Lukelectro/PowerNode/HiLink_Ali.jpg

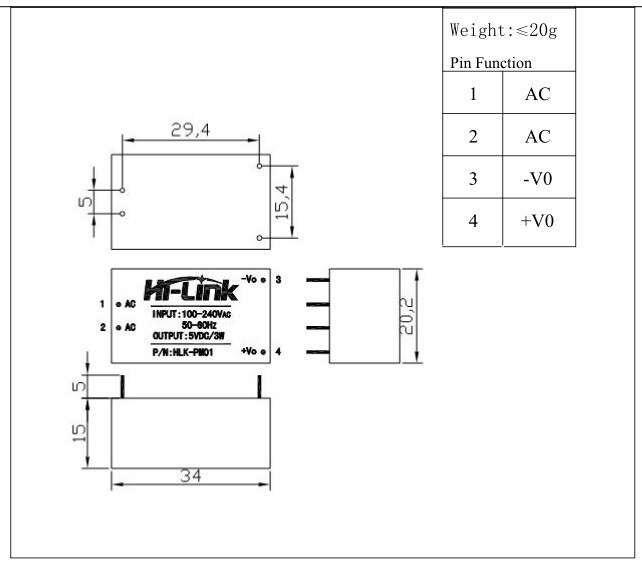
HiLink_Ali.jpg
