Lukelectro/PowerNode/Poesp_1.0.pdf

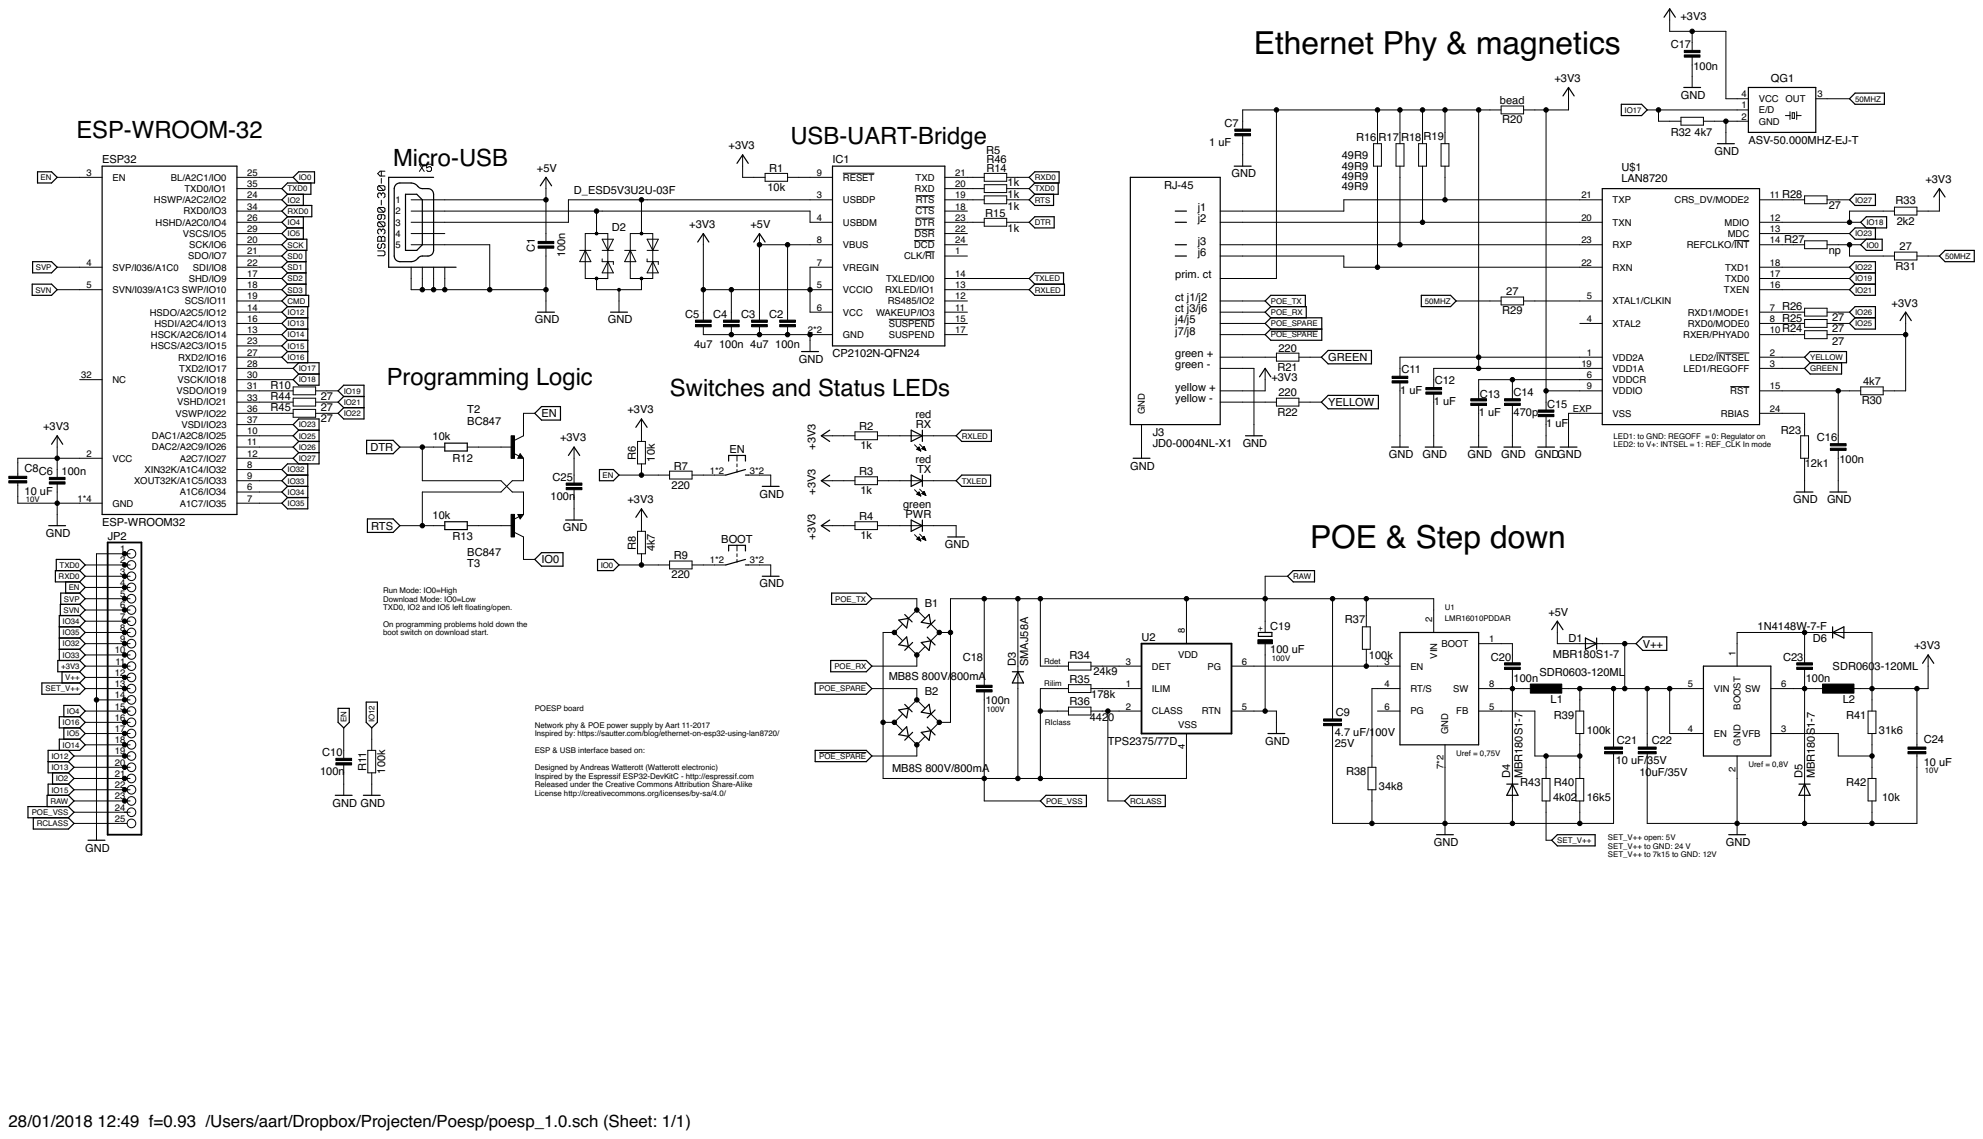
[picture p2: page 1]

Switches and Status LEDs Programming Logic

LED1: to GND: REGOFF = 0: Regulator on
LED2: to V+: INTSEL = 1: REF_CLK In mode

Run Mode: IO0=High Download Mode: IO0=Low

TXD0, IO2 and IO5 left floating/open. On programming problems hold down the

boot switch on download start.

POESP board Network phy & POE power supply by Aart 11-2017

Inspired by: https://sautter.com/blog/ethernet-on-esp32-using-lan8720/ ESP & USB interface based on: Designed by Andreas Watterott (Watterott electronic)

Inspired by the Espressif ESP32-DevKitC - http://espressif.com
Released under the Creative Commons Attribution Share-Alike
License http://creativecommons.org/licenses/by-sa/4.0/

28/01/2018 12:49 f=0.93 /Users/aart/Dropbox/Projecten/Poesp/poesp_1.0.sch (Sheet: 1/1)
