Lukelectro/PowerNode/PoESP_Powernode_v1p1_zoals_board_gemaakt_is.pdf

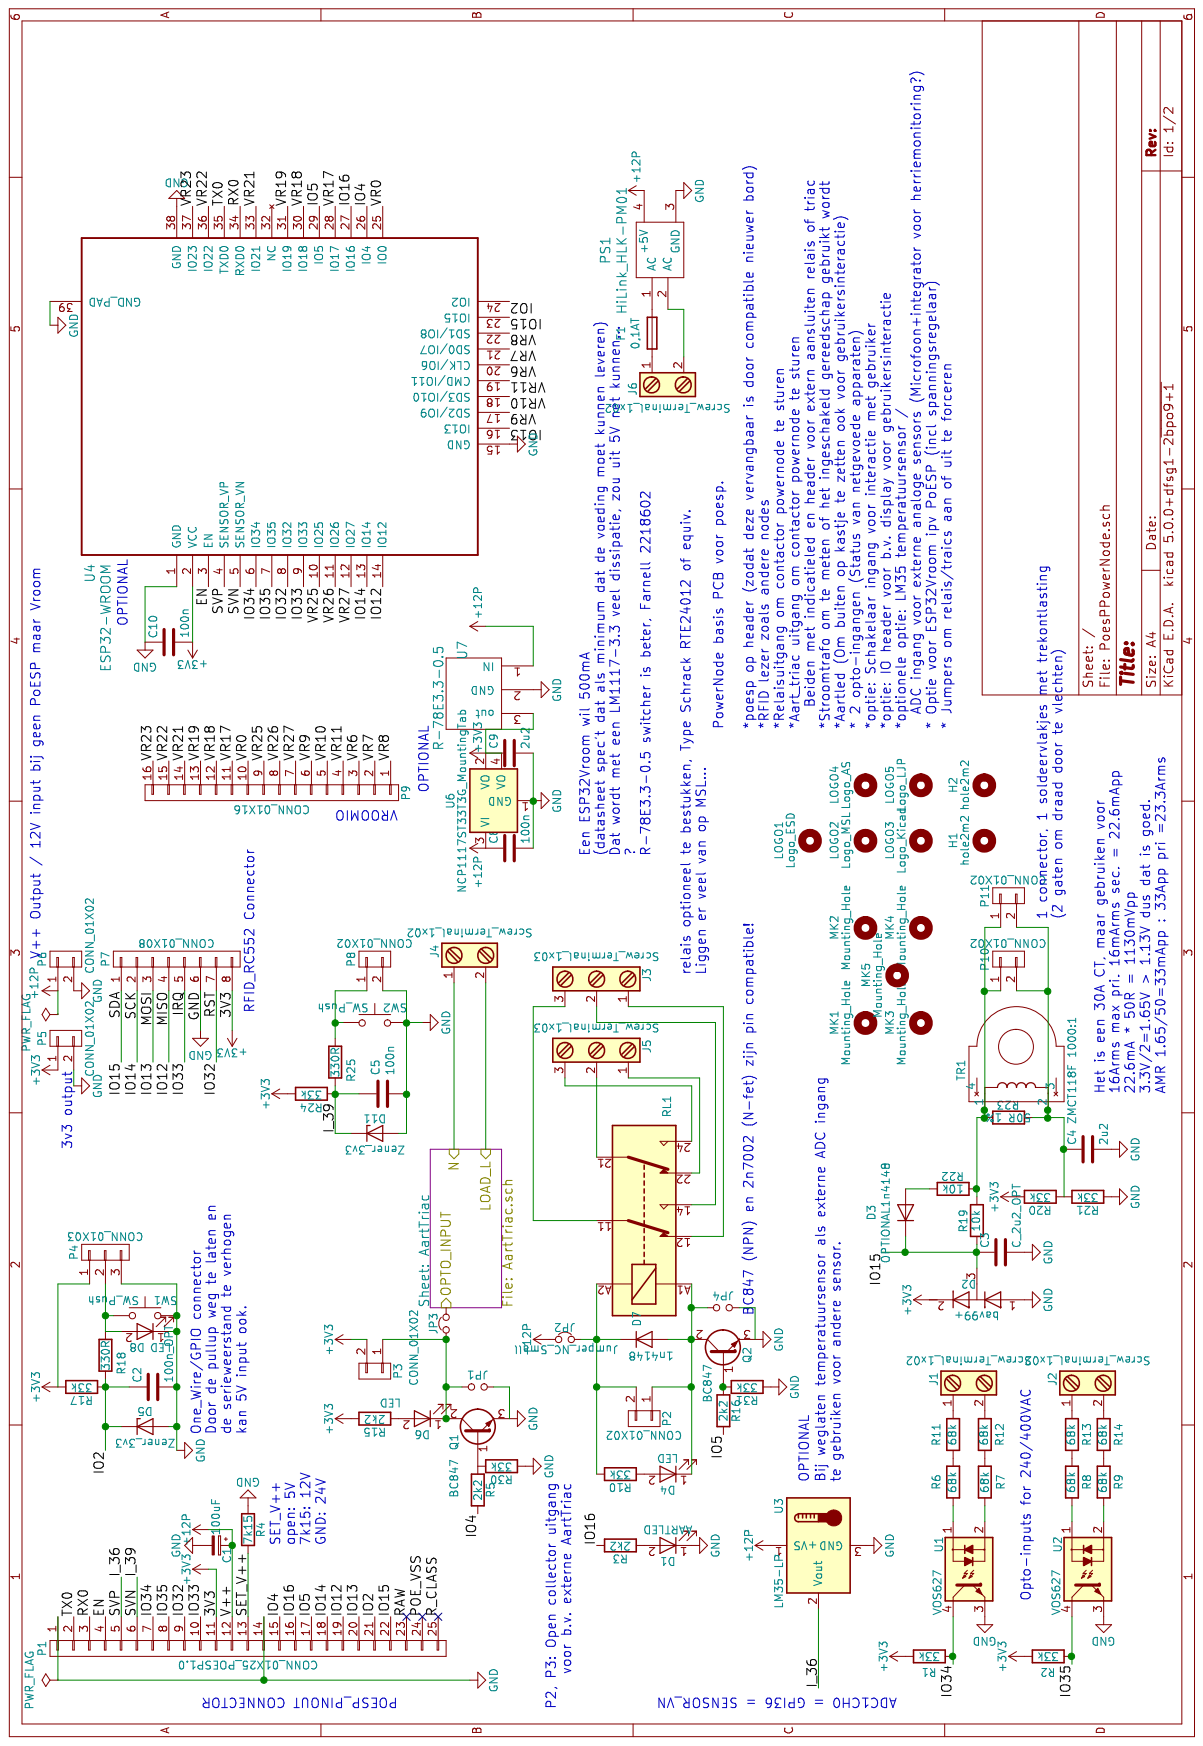
[picture p3: page 1]

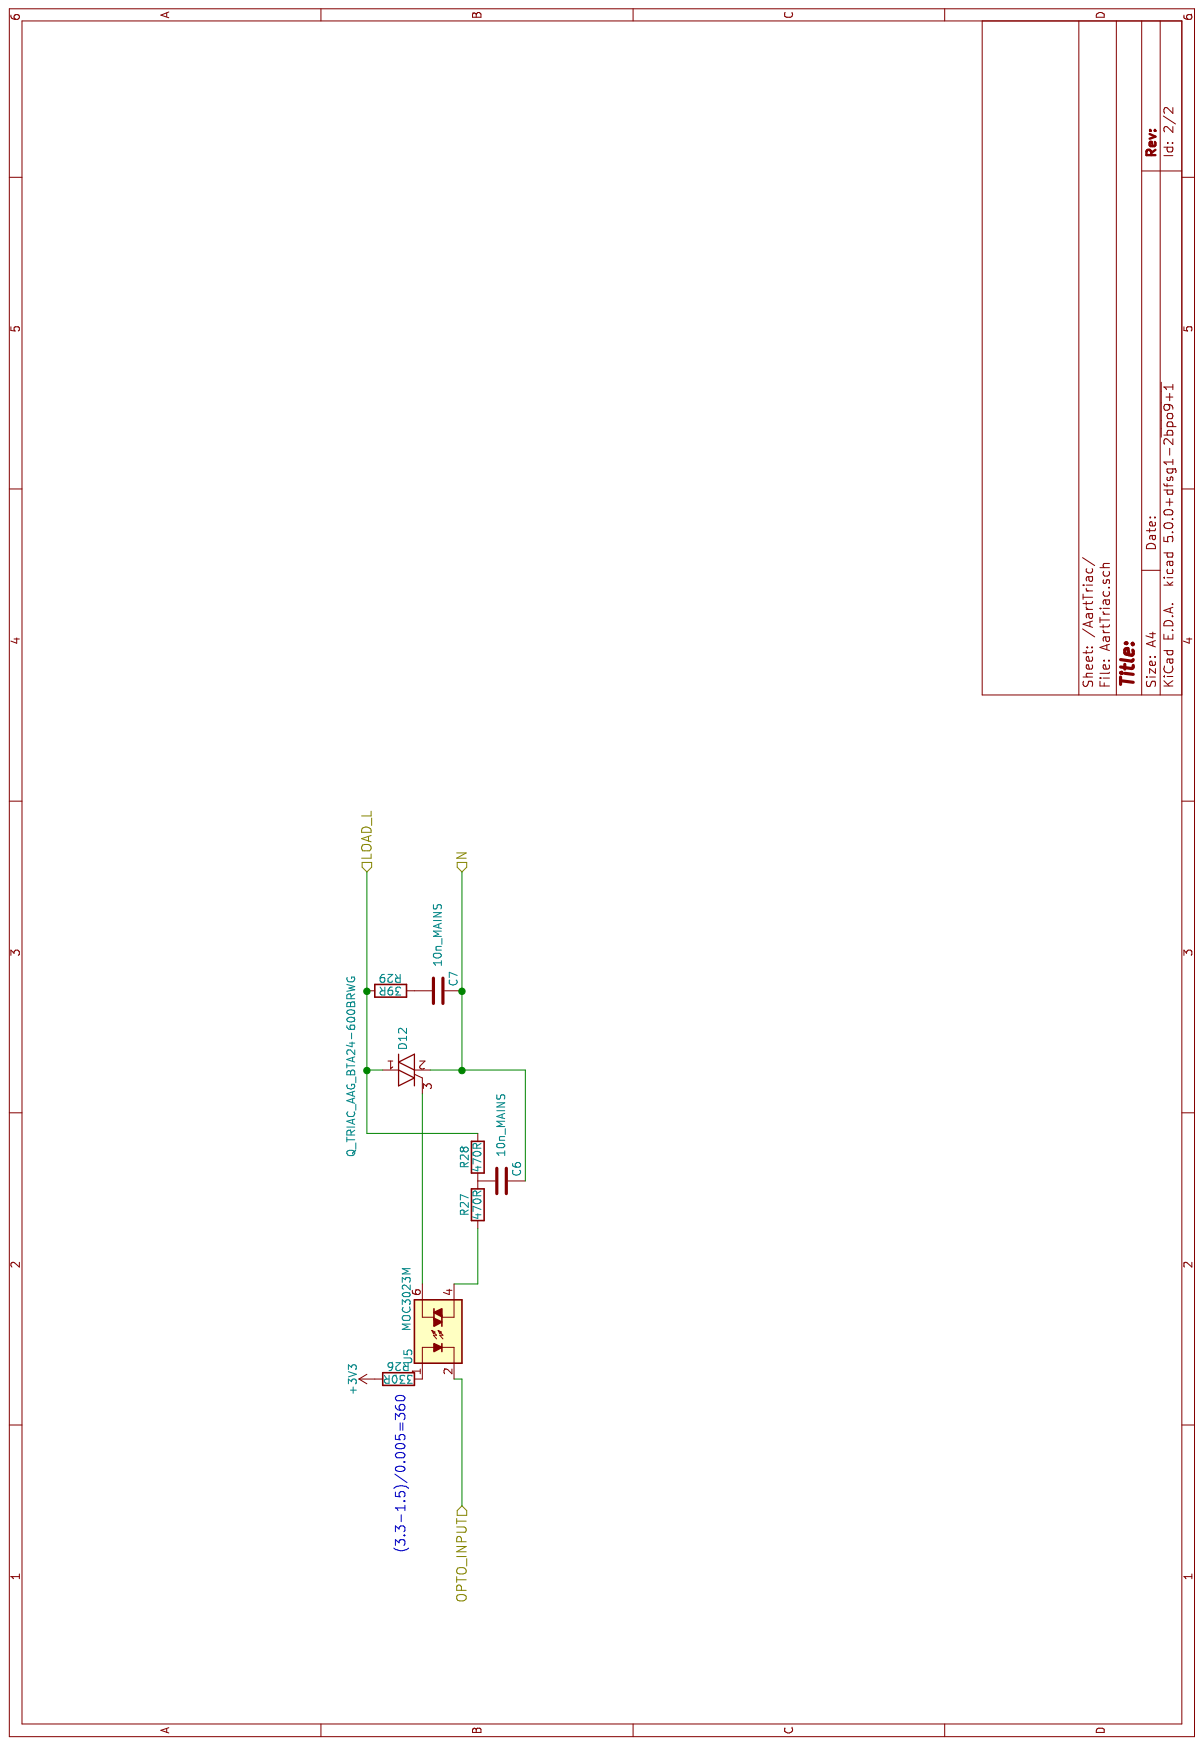
[picture p4: page 2]
