Lukelectro/PowerNode/(commit log)

2018-10-21 Powernode basisboard v1.1 zoals er pcb's van gemaakt zijn. Zie ook https://wiki.makerspaceleiden.nl/mediawiki/index.php/Powernode_1.1
    [AartTriac.sch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]
2018-11-03 git attributes because linguist thinks the .GML gerber is in Game Maker Language while it is a gerber file instead
